Gabyel9/logibox-bit-deploy/firmware/LogiBox_ESP32CAM/LogiBox_ESP32CAM/LogiBox_ESP32CAM.ino

/*
  LogiBox - ESP32-CAM Snapshot Camera
  -----------------------------------
  Captures a JPEG every CAPTURE_INTERVAL_MS while "capturing" and uploads it
  to the LogiBox web app via the Vercel /api/camera-upload endpoint.

  NON-BLOCKING: capture + upload run in a background task on core 0, so the
  web server (main loop) keeps answering /start, /stop and /status instantly
  even while a slow upload is in flight. If an upload is still running when
  the next capture interval fires, that frame is skipped - no backlog.

  The capture loop is started/stopped by the keypad ESP32 (LogiBox_OTP_Vault):
      http://<THIS_IP>/start   -> begin capturing
      http://<THIS_IP>/stop    -> stop capturing

  Board: AI-Thinker ESP32-CAM (OV2640)
  Libraries required (Arduino Library Manager or git clone into Arduino/libraries):
    - esp32-camera  (https://github.com/espressif/esp32-camera)
    - WiFiManager   (tablatronix, via Library Manager)
    - Built-in: WiFi, WebServer, HTTPClient, WiFiClientSecure, ESPmDNS

  IMPORTANT:
    - Must be on the SAME 2.4GHz WiFi network as the keypad ESP32.
    - WiFi is configured with WiFiManager: on first boot (or when the saved
      network is gone) this device starts a portal AP named "LogiBoxCam".
      Join it from a phone, open http://192.168.4.1, and enter the WiFi
      credentials once - they are stored in NVS and survive re-flashes.
    - To join a DIFFERENT WiFi network later: power the camera on, wait
      about 2 seconds, then press and HOLD the FLASH button (GPIO0) for
      3 seconds, then RELEASE it. The camera wipes its saved WiFi and
      reopens the "LogiBoxCam" portal - join it from a phone, open
      http://192.168.4.1, and enter the new network's credentials.
    - NOTE: GPIO0 is the camera's XCLK pin and a boot-strap pin. On the
      AI-Thinker board the flash LED is GPIO4; the physical FLASH button
      only exists on the ESP32-CAM-MB programmer board (GPIO0 to GND).
      Do NOT hold GPIO0 while powering on - that puts the chip in
      download (flash) mode instead of running this sketch.
    - The keypad finds this camera via the mDNS hostname "logiboxcam".
    - The ESP32-CAM has no USB; use a USB-TTL adapter (3.3V) connected to
      GPIO1 (TX), GPIO3 (RX), GND, and hold GPIO0 to GND while plugging in
      to enter download mode.
*/

#include <WiFi.h>
#include <WiFiClientSecure.h>
#include <HTTPClient.h>
#include <WebServer.h>
#include <WiFiManager.h>
#include <ESPmDNS.h>
#include "esp_camera.h"
#include <string.h>
#include "freertos/FreeRTOS.h"
#include "freertos/task.h"

// ---------------- CONFIG: EDIT THESE ----------------
// WiFi credentials are NOT stored here - configure them once per device via
// the WiFiManager portal (AP name "LogiBoxCam", http://192.168.4.1).

// This device's ID - must match a device doc in Firestore:
//   devices/esp32-cam-001 = { ownerUid: "<your uid>", status: "active" }
const char* DEVICE_ID     = "esp32-cam-001";

// Vercel API endpoint for snapshot uploads
const char* FUNCTION_URL  = "https://logibox-bit-deploy-3xzd.vercel.app/api/camera-upload";

// Capture interval - 3 seconds gives good delivery-evidence density while
// staying on top of upload time and Firestore's free write quota
const unsigned long CAPTURE_INTERVAL_MS = 3000;

// mDNS hostname the keypad uses to find this camera on the LAN.
const char* MDNS_HOSTNAME = "logiboxcam";

// GPIO0 is the FLASH button on the ESP32-CAM-MB programmer board (it
// connects GPIO0 to GND). Hold it for ~3 seconds shortly after power-on to
// erase saved WiFi settings and reopen the "LogiBoxCam" setup portal (use
// this to join a NEW WiFi network). GPIO0 must be read BEFORE the camera is
// initialized, because the camera driver uses it as the 20MHz XCLK clock.
#define FORCE_PORTAL_BUTTON_GPIO 0
// -----------------------------------------------------

// ---------------- Camera State ----------------
WebServer server(80);
bool capturing = false;
unsigned long lastCaptureTime = 0;
unsigned long framesUploaded = 0;
unsigned long lastUploadMs = 0;
int lastHttpCode = 0;

// Capture + upload run in a background task so the web server never blocks.
// The main loop only flags that a frame is due; if a previous upload is still
// running, the frame is skipped (no backlog) instead of freezing /stop,/start.
TaskHandle_t uploadTaskHandle = NULL;
volatile bool uploadPending = false;

// One TLS + HTTP keep-alive connection, reused for every frame upload.
// Creating a fresh WiFiClientSecure per frame (every 3s) exhausts heap and
// the radio, which shows up as "connection refused" on every upload.
WiFiClientSecure secureClient;
HTTPClient http;

// Self-heal counters: N consecutive connect/upload failures, or a silent
// upload stall while capturing, trigger an automatic reboot (the modem can
// wedge under sustained capture+TLS load and stop answering mDNS).
int consecutiveConnectFailures = 0;

// Re-announce mDNS whenever WiFi reconnects, so the keypad rediscovers us
// without a manual power cycle.
bool mdnsAnnounced = true;

// Delivery session state. Every frame uploaded during a session is tagged with
// these so the web app can group them and label the session with a vault id.
String sessionId = "";
String currentVaultId = "";

// ---------------- Camera Pin Configuration (AI-Thinker) ----------------

#define CAMERA_MODEL_AI_THINKER
#define PWDN_GPIO_NUM     32
#define RESET_GPIO_NUM    -1
#define XCLK_GPIO_NUM     0
#define SIOD_GPIO_NUM     26
#define SIOC_GPIO_NUM     27
#define Y9_GPIO_NUM       35
#define Y8_GPIO_NUM       34
#define Y7_GPIO_NUM       39
#define Y6_GPIO_NUM       36
#define Y5_GPIO_NUM       21
#define Y4_GPIO_NUM       19
#define Y3_GPIO_NUM       18
#define Y2_GPIO_NUM       5
#define VSYNC_GPIO_NUM    25
#define HREF_GPIO_NUM     23
#define PCLK_GPIO_NUM     22

void setup() {
  Serial.begin(115200);
  Serial.println("=== LogiBox ESP32-CAM Starting ===");
  delay(300);

  // Check for the force-portal button BEFORE the camera is initialized.
  // GPIO0 doubles as the camera's XCLK clock and as a boot-strap pin, so it
  // can only be read cleanly at this point, right after power-on.
  Serial.println("(To force WiFi setup: within ~5s hold FLASH for 3s.)");
  if (forcePortalRequested()) {
    Serial.println("\n=== FORCE SETUP PORTAL ===");
    Serial.println("FLASH button held 3s - erasing saved WiFi settings.");

    WiFiManager wm;
    wm.resetSettings();
    delay(1000);
    Serial.println("Saved WiFi erased.");
    Serial.println("RELEASE the FLASH button now, then join the 'LogiBoxCam'");
    Serial.println("hotspot from your phone and open http://192.168.4.1");

    // Only reboot once the button is released: GPIO0 held low during reset
    // would strap the chip into download mode instead of running the sketch.
    // If it is still held, fall through - with no saved network, the portal
    // opens in this boot anyway.
    if (waitForRelease()) {
      Serial.println("Button released. Rebooting into the setup portal...");
      delay(500);
      ESP.restart();
    } else {
      Serial.println("Button still held - continuing; portal will still open.");
    }
  }

  initCamera();

  connectWiFi();

  // One persistent TLS + HTTP keep-alive connection for all frame uploads.
  secureClient.setInsecure();
  http.setTimeout(5000);
  http.setReuse(true);
  // Content-Type is identical for every frame. It must be set once here:
  // HTTPClient only discards its header list in end() - which is deliberately
  // never called (keep-alive) - so addHeader() per frame would leak memory.
  http.addHeader("Content-Type", "application/octet-stream");
  lastUploadMs = millis();

  setupRoutes();

  // Background task handles capture + upload so the web server never blocks.
  xTaskCreatePinnedToCore(uploadTask, "upload", 8192, NULL, 1, &uploadTaskHandle, 0);

  Serial.println("ESP32-CAM ready!");
  Serial.print("Stream control: http://");
  Serial.print(MDNS_HOSTNAME);
  Serial.println(".local/start");
  Serial.print("or via IP: http://");
  Serial.print(WiFi.localIP());
  Serial.println("/start");
}

void loop() {
  server.handleClient();

  // WiFi recovery: the ESP32-CAM radio can drop its association mid-session
  // under sustained capture + TLS load. Reconnect and re-announce mDNS so the
  // keypad finds us again without a manual power cycle.
  if (WiFi.status() != WL_CONNECTED) {
    mdnsAnnounced = false;
    static unsigned long lastReconnectAttempt = 0;
    if (millis() - lastReconnectAttempt >= 10000UL) {
      lastReconnectAttempt = millis();
      Serial.println("WiFi lost - reconnecting");
      WiFi.reconnect();
    }
  } else if (!mdnsAnnounced) {
    mdnsAnnounced = true;
    MDNS.begin(MDNS_HOSTNAME);
    MDNS.addService("http", "tcp", 80);
    Serial.println("mDNS re-announced after reconnect");
  }

  // Self-heal: a wedged upload task or a dead TLS path stalls all frames. If
  // nothing uploads in ~60s, or the last 5 attempts all failed, reboot.
  if (capturing) {
    if (consecutiveConnectFailures >= 5) {
      Serial.println("5 consecutive upload failures - rebooting camera");
      delay(500);
      ESP.restart();
    }
    if (millis() - lastUploadMs >= 60000UL) {
      Serial.println("No successful upload in 60s - rebooting camera");
      delay(500);
      ESP.restart();
    }
  }

  if (capturing && millis() - lastCaptureTime >= CAPTURE_INTERVAL_MS) {
    lastCaptureTime = millis();
    if (!uploadPending) {
      uploadPending = true;  // if a previous upload is still running, skip this frame
    }
  }
}

// Runs on core 0. Does the slow capture + upload work so the web server on
// the main loop keeps answering /start, /stop, /status instantly.
void uploadTask(void* param) {
  for (;;) {
    if (uploadPending) {
      uploadPending = false;
      captureAndUpload();
    }
    vTaskDelay(pdMS_TO_TICKS(20));
  }
}

// ---------------- Camera Init ----------------

void initCamera() {
  camera_config_t config;
  config.ledc_channel = LEDC_CHANNEL_0;
  config.ledc_timer = LEDC_TIMER_0;
  config.pin_d0 = Y2_GPIO_NUM;
  config.pin_d1 = Y3_GPIO_NUM;
  config.pin_d2 = Y4_GPIO_NUM;
  config.pin_d3 = Y5_GPIO_NUM;
  config.pin_d4 = Y6_GPIO_NUM;
  config.pin_d5 = Y7_GPIO_NUM;
  config.pin_d6 = Y8_GPIO_NUM;
  config.pin_d7 = Y9_GPIO_NUM;
  config.pin_xclk = XCLK_GPIO_NUM;
  config.pin_pclk = PCLK_GPIO_NUM;
  config.pin_vsync = VSYNC_GPIO_NUM;
  config.pin_href = HREF_GPIO_NUM;
  config.pin_sscb_sda = SIOD_GPIO_NUM;
  config.pin_sscb_scl = SIOC_GPIO_NUM;
  config.pin_pwdn = PWDN_GPIO_NUM;
  config.pin_reset = RESET_GPIO_NUM;
  config.xclk_freq_hz = 20000000;
  config.pixel_format = PIXFORMAT_JPEG;

  config.grab_mode = CAMERA_GRAB_WHEN_EMPTY;
  config.fb_location = CAMERA_FB_IN_PSRAM;
  config.fb_count = 2;

  // VGA (640x480) keeps each snapshot small enough to store in Firestore
  config.frame_size = FRAMESIZE_VGA;
  config.jpeg_quality = 12;

  esp_err_t err = esp_camera_init(&config);
  if (err != ESP_OK) {
    Serial.printf("Camera init failed with error 0x%x\n", err);
    return;
  }

  sensor_t* s = esp_camera_sensor_get();
  if (s) {
    s->set_framesize(s, FRAMESIZE_VGA);
    s->set_quality(s, 12);
  }
}

// ---------------- WiFi ----------------

void connectWiFi() {
  Serial.println("Connecting to WiFi via WiFiManager...");

  WiFi.mode(WIFI_STA);

  WiFiManager wm;
  wm.setConfigPortalTimeout(180); // give 3 min for phone setup, then reboot

  String savedSSID = wm.getWiFiSSID();
  if (savedSSID.length() > 0) {
    Serial.print("Saved WiFi network: ");
    Serial.println(savedSSID);
  } else {
    Serial.println("No saved WiFi network - first boot or settings erased.");
  }

  wm.setAPCallback([](WiFiManager* wm) {
    Serial.println("\n=== WIFI SETUP REQUIRED ===");
    Serial.println("Join the 'LogiBoxCam' hotspot from your phone,");
    Serial.println("open http://192.168.4.1 and enter your WiFi credentials.");
  });

  if (!wm.autoConnect("LogiBoxCam")) {
    Serial.println("\nWiFi FAILED to connect!");
    return;
  }

  Serial.println("\nWiFi connected!");
  Serial.print("Network (SSID): ");
  Serial.println(WiFi.SSID());
  Serial.print("IP Address: ");
  Serial.println(WiFi.localIP());
  Serial.print("MAC Address: ");
  Serial.println(WiFi.macAddress());

  if (MDNS.begin(MDNS_HOSTNAME)) {
    MDNS.addService("http", "tcp", 80);
    Serial.print("mDNS started: ");
    Serial.print(MDNS_HOSTNAME);
    Serial.println(".local");
  }
}

// Returns true if the FLASH button (GPIO0) is held down for ~3 seconds within
// a short window right after power-on. Used to force the setup portal so the
// camera can join a new WiFi network.
// MUST be called BEFORE initCamera(): the camera driver reconfigures GPIO0 as
// the 20MHz XCLK clock, which makes the button unreadable.
bool forcePortalRequested() {
  // How long to keep listening for a button press after boot (gives you time
  // to press the FLASH button once the board is powered up). A press starting
  // at any point within this window still gets its full 3s hold (see below).
  const unsigned long WINDOW_MS = 10000;
  // How long the button must be held continuously to trigger the portal.
  const unsigned long HOLD_MS   = 3000;

  pinMode(FORCE_PORTAL_BUTTON_GPIO, INPUT_PULLUP);
  delay(100); // let the line settle

  unsigned long windowStart = millis();
  unsigned long heldSince = 0;

  // Keep listening until the window lapses AND no hold is in progress. Once a
  // press starts, we keep waiting so the hold can finish even if the window
  // would otherwise expire mid-hold.
  while (millis() - windowStart < WINDOW_MS || heldSince > 0) {
    if (digitalRead(FORCE_PORTAL_BUTTON_GPIO) == LOW) {
      if (heldSince == 0) {
        heldSince = millis();
      }
      if (millis() - heldSince >= HOLD_MS) {
        return true; // held for the full 3 seconds
      }
    } else {
      heldSince = 0; // released too early - start counting again
    }
    delay(20);
  }
  return false; // never held long enough during the window
}

// Blocks until the FLASH button (GPIO0) is released, or until a timeout.
// Returns true if it was released. Needed before rebooting: GPIO0 held low
// during reset straps the chip into download mode, so the sketch never runs.
bool waitForRelease() {
  const unsigned long TIMEOUT_MS = 10000;
  unsigned long start = millis();
  while (millis() - start < TIMEOUT_MS) {
    if (digitalRead(FORCE_PORTAL_BUTTON_GPIO) != LOW) {
      return true; // released
    }
    delay(50);
  }
  return false; // still held after the timeout
}

// ---------------- Web Server Routes ----------------

void setupRoutes() {
  // Start capturing (called by the keypad ESP32 when a session starts).
  // Optional query param: ?vault=<id> labels the session with the vault being
  // opened (sent by the keypad once the delivery vault is selected).
  server.on("/start", HTTP_GET, []() {
    capturing = true;
    lastCaptureTime = millis();

    if (sessionId.length() == 0) {
      sessionId = "s" + String((uint32_t)millis());
      framesUploaded = 0;
      consecutiveConnectFailures = 0;
      lastUploadMs = millis();
    }

    String vault = server.arg("vault");
    if (vault.length() > 0) {
      currentVaultId = vault;
      Serial.print("Vault set: ");
      Serial.println(currentVaultId);
    }

    Serial.print("Capture STARTED (session ");
    Serial.print(sessionId);
    Serial.println(")");
    server.send(200, "application/json", "{\"success\":true,\"capturing\":true}");
  });

  // Stop capturing (called by the keypad ESP32 when returning to idle)
  server.on("/stop", HTTP_GET, []() {
    capturing = false;
    sessionId = "";
    currentVaultId = "";
    Serial.println("Capture STOPPED");
    server.send(200, "application/json", "{\"success\":true,\"capturing\":false}");
  });

  // Debug status
  server.on("/status", HTTP_GET, []() {
    String json = "{";
    json += "\"capturing\":" + String(capturing ? "true" : "false") + ",";
    json += "\"framesUploaded\":" + String(framesUploaded) + ",";
    json += "\"lastHttpCode\":" + String(lastHttpCode);
    json += "}";
    server.send(200, "application/json", json);
  });

  // Diagnostic: shows where the camera is and what it's doing.
  server.on("/whoami", HTTP_GET, []() {
    String json = "{";
    json += "\"ip\":\"" + WiFi.localIP().toString() + "\",";
    json += "\"ssid\":\"" + String(WiFi.SSID()) + "\",";
    json += "\"hostname\":\"" + String(MDNS_HOSTNAME) + "\",";
    json += "\"capturing\":" + String(capturing ? "true" : "false");
    json += "}";
    server.send(200, "application/json", json);
  });

  server.begin();
  Serial.println("Web server started");
}

// ---------------- Capture + Upload ----------------

void captureAndUpload() {
  camera_fb_t* fb = esp_camera_fb_get();
  if (!fb) {
    Serial.println("Camera capture failed");
    return;
  }

  if (fb->len == 0) {
    Serial.println("Empty frame captured");
    esp_camera_fb_return(fb);
    return;
  }

  if (WiFi.status() != WL_CONNECTED) {
    Serial.println("WiFi down, skipping upload");
    esp_camera_fb_return(fb);
    return;
  }

  uploadFrame(fb);

  esp_camera_fb_return(fb);
}

// Uploads the raw JPEG bytes as a binary POST body.
// deviceId travels in the query string to keep the body purely the image.
void uploadFrame(camera_fb_t* fb) {
  Serial.printf("Uploading frame: %u bytes\n", fb->len);

  String url = String(FUNCTION_URL) + "?deviceId=" + DEVICE_ID;
  if (sessionId.length() > 0) {
    url += "&sessionId=" + sessionId;
  }
  if (currentVaultId.length() > 0) {
    url += "&vaultId=" + currentVaultId;
  }

  // Reuses the persistent secureClient + http handle (keep-alive). begin()
  // transparently reconnects if the server dropped the previous connection.
  // Never call http.end() here: that tears down the TLS socket and we would be
  // back to a fresh handshake - and fresh heap churn - every single frame.
  if (!http.begin(secureClient, url)) {
    consecutiveConnectFailures++;
    Serial.print("TLS connect failed (");
    Serial.print(consecutiveConnectFailures);
    Serial.println(" consecutive) - skipping frame");
    return;
  }

  int httpCode = http.POST(fb->buf, fb->len);
  lastHttpCode = httpCode;

  if (httpCode == 200) {
    consecutiveConnectFailures = 0;
    framesUploaded++;
    lastUploadMs = millis();
    Serial.print("Upload OK (");
    Serial.print(framesUploaded);
    Serial.println(" frames)");
  } else if (httpCode > 0) {
    Serial.print("Upload failed, HTTP ");
    Serial.println(httpCode);
  } else {
    consecutiveConnectFailures++;
    Serial.print("Upload error: ");
    Serial.println(http.errorToString(httpCode));
  }
}
