Gabyel9/logibox-bit-deploy/firmware/LogiBox_OTP_Vault/LogiBox_OTP_Vault/types.h

#ifndef TYPES_H
#define TYPES_H

#include <Arduino.h>

// ─── Sensor State ───
struct DoorState {
  bool closed;
  bool pending;
  unsigned long pendingSince;
};

struct ParcelState {
  bool present;
  bool pending;
  unsigned long pendingSince;
};

// ─── Solenoid Lock State ───
struct LockState {
  bool unlocked;
  bool doorOpenedDuringUnlock;
  bool parcelDetectedDuringUnlock;
  unsigned long unlockedAt;
  unsigned long parcelRemovedSince;   // millis() when IR first went empty (0 = not pending)
  bool remoteSession;                 // opened by a dashboard remote-open command
                                      // (collect-and-close flow: reed switch only,
                                      // no parcel/cash-pod stages)
};

// ─── Cash Pod Phase (PCA9685 servo trapdoor) ───
// The servo sweeps slowly (pulse-width ramp) instead of snapping, like a
// wire-pulled trapdoor. Phases drive that motion state machine.
enum PodPhase {
  POD_IDLE = 0,        // locked; servo signal OFF (limp, sheet rests by gravity)
  POD_RAISING,         // ramp LOCKED -> UNLOCKED (sheet pulling UP)
  POD_OPEN,            // held fully open (UNLOCKED pulse) for SERVO_POD_OPEN_MS
  POD_LOWERING,        // ramp UNLOCKED -> LOCKED (sheet dropping DOWN / re-lock)
  POD_SETTLING         // holding LOCKED for SERVO_POD_SETTLE_MS before going limp
};

struct PodState {
  PodPhase      phase;             // current motion phase (see PodPhase)
  uint16_t      pulseUs;           // last pulse width actually written
  unsigned long phaseStartedAt;    // millis() when the current phase began
  unsigned long openAt;            // millis() when the pod reached fully OPEN
};

// ─── Network Messages ───
enum NetworkOp {
  OP_START_CAMERA,
  OP_STOP_CAMERA,
  OP_VERIFY_OTP,
  OP_LOG_TAMPER,
  OP_REPORT_EVENT,
  OP_CAMERA_STATUS
};

typedef struct {
  NetworkOp op;
  char reqVault[2];
  char reqOtp[7];
  char reqEvent[24];
  int  resultCode;
  char resultBody[512];
} NetMsg;

// ─── Remote Unlock Commands ───
// Handed over by the network task's /api/device-poll call; the main loop
// drains them (netCmdQueue) because it owns locks[] and the LCD.
struct RemoteCmd {
  char vaultId[4];   // "1".."3", NUL-terminated
};

// ─── Screen State Machine ───
enum ScreenState {
  WELCOME,
  SELECT_VAULT,
  ENTER_OTP,
  VERIFYING,
  RESULT,
  LOCKOUT,
  SHOW_STATUS,
  CAMERA_CHECK,
  DOOR_UNLOCKED
};

#endif
