Gabyel9/logibox-bit-deploy/(commit log)

2026-06-16 filter date still fixing some security functions
2026-07-03 Add device OTP verification API and update Firebase functions
2026-07-15 Fix empty strings in user profile creation
    [LogiBox_OTP_Vault.ino]
2026-07-21 Add firebaseapp.com to frame-src
2026-07-22 trying device
2026-07-22 Fix Firebase initialization in device-verify-otp
2026-08-02 Camera evidence history: capture sessions, gallery, download
2026-08-02 Drop door controller: single-ESP vault (OTP + camera), Converge WiFi
2026-08-03 Fix ESP32-CAM upload: pass non-const payload to HTTPClient::POST
    [LogiBox_ESP32CAM.ino]
2026-08-03 WiFiManager portal + mDNS camera discovery: configure WiFi once per device via phone, works on any network
2026-08-03 Fix mDNS query for ESP32 core 3.x: queryHost returns IPAddress
    [LogiBox_OTP_Vault.ino]
2026-08-03 Fix idle-timeout loop spamming camera stop; reset timer and only stop once
    [LogiBox_OTP_Vault.ino]
2026-08-03 Add MOVING_TO_NEW_WIFI.txt guide for reconnecting devices to a different network
2026-08-24 Solenoid locks, camera provisioning, firmware cleanup
    - OTP Vault: per-vault solenoid locks via 4ch relay (unlock on OTP success,
    close-door re-lock via reeds, 30s failsafe) + new config.h/types.h
    - ESP32-CAM: WiFiManager portal, FLASH-button reset, session/vault tagging
    - Firestore rules: scope camera collections under users/{uid}
    - Remove obsolete Door Controller sketch (superseded by relay control)
    - Delete stale duplicate firmware copy under logibox/firmware
    [LogiBox_ESP32CAM.ino, LogiBox_OTP_Vault.ino, config.h, types.h]
2026-09-01 Rate limiting for vaults without active OTP + 3-stage parcel delivery flow
    - device-verify-otp (Vercel x2 + Cloud Function): record failed attempt on
    400 'OTP is not active' / 'OTP has expired' so rate limits apply to all
    vaults, not just ones with an active OTP
    - ESP32 firmware: registerLocalFailure() on 400 responses for client-side
    lockout parity
    - ESP32 firmware: 3-stage delivery flow - pull door open, place parcel
    (IR-confirmed), close door to relock; relocks with 'No parcel detected'
    warning if door closes without a parcel
    - SETUP_INSTRUCTIONS: correct reed/relay pins to match config.h
    Checkpoint before website delivery-lifecycle feature.
    [LogiBox_OTP_Vault.ino, config.h, types.h]
2026-09-01 Add delivery event pipeline: device staged reports, dashboard progress UI, 3-stage simulator
    - api/device-event.js: new endpoint (session_start, door_opened,
    parcel_placed, door_closed_locked, no_parcel, auto_locked) that applies
    vault flag updates and writes activity logs under the device owner uid
    - device-verify-otp.js / functions/index.js: OTP success starts a delivery
    session (deliveryInProgress=true) instead of marking the vault occupied
    - firmware: OP_REPORT_EVENT + reqEvent on NetMsg, EVENT_FUNCTION_URL,
    sendEventInternal()/requestEventReport() fire-and-forget POSTs at each
    stage gate in checkLockStates() and on OTP success
    - Dashboard: amber 'Delivery in progress' pill / g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
2026-09-01 Fix vault stranded in 'completed': watchdog auto-reset, manual reset, confirm normalization
    - Self-healing effect auto-resets any vault still 'completed' after 2s,
    retrying once on failure (survives reloads; replaces the fragile
    fire-and-forget 1.5s timer in the confirm handler)
    - Completed card now has a Reset button as a manual escape
    - handleConfirmWithWarning no longer lets an activity-log failure block
    recovery, and clears leftover OTP fields so confirm can't leave a
    status+otpStatus hybrid ('completed' + 'expired')
2026-09-15 Cash pod servos: slow wire-pull ramp, sleep-idle, sticky-keypad skip fix
    - Servos now ramp pulse width at SERVO_RAMP_US_PER_SEC (default ~2.6s)
    instead of snapping instantly; open window starts after the raise ramp
    - Servos go limp (signal off) after locking (SERVO_POD_SETTLE_MS) so they
    no longer grind their endstops 24/7; sheets rest locked by gravity
    - Staggered boot snap (BOOT_SERVO_STAGGER_MS) to limit buck inrush
    - Fix keypad freezing when a key skips the 'Releasing cash!'/'Auto-locked'
    flash in DOOR_UNLOCKED state (flashSkipRequested captures the skip)
    - PodState/pods reworked to a phase state machine (IDLE/RAISING/OPEN/
    LOWERING/SETTLING)
    - SETUP_INSTRUCTIONS updated: direct-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
    [LogiBox_OTP_Vault.ino, config.h, types.h]
2026-09-22 Add parcel_removed handling, camera stop on idle, 3s capture interval
2026-09-24 Delivery safety + relay grounding docs, 120s OTP cooldown, user guide; fix .gitignore merge markers
2026-09-26 Humanize activity log device events, fix double-escaped log and rider text, rename Receiver Name to Delivery Rider
    [config.h]
2026-09-28 Remove Live/Offline status badge from camera feed
2026-10-10 Stop camera on session end, per-session frame dedupe, ESP32-CAM connectivity check (C key)
2026-10-10 Remote unlock holds relay until door opened/closed or 30s auto-lock; hide camera hint on WELCOME
2026-10-11 Rotate ESP32-CAM frames upright; show OTP regen cooldown on Regenerate buttons
2026-10-11 Log device lockout in activity logs; rotate downloaded ESP32-CAM frames upright
2026-10-12 Add ESP32 flashing quick-start; group device OTP/lockout logs under Vault filter
2026-10-14 Add Prepaid delivery option; camera mDNS fallback IP + MAC logging
